heli2src/GRBL_MPG_DRO_with_Teensy_and_mpgWheels/docs/mpg_wheel/readme.txt

 Adafruit Silicone Elastomer 4x4 Button Keypad - for 3mm LEDs
https://eckstein-shop.de/AdafruitSiliconeElastomer4x4ButtonKeypad-for3mmLEDsEN	6,95
