heli2src/GRBL_MPG_DRO_with_Teensy_and_mpgWheels/docs/images/rs485_board.jpg

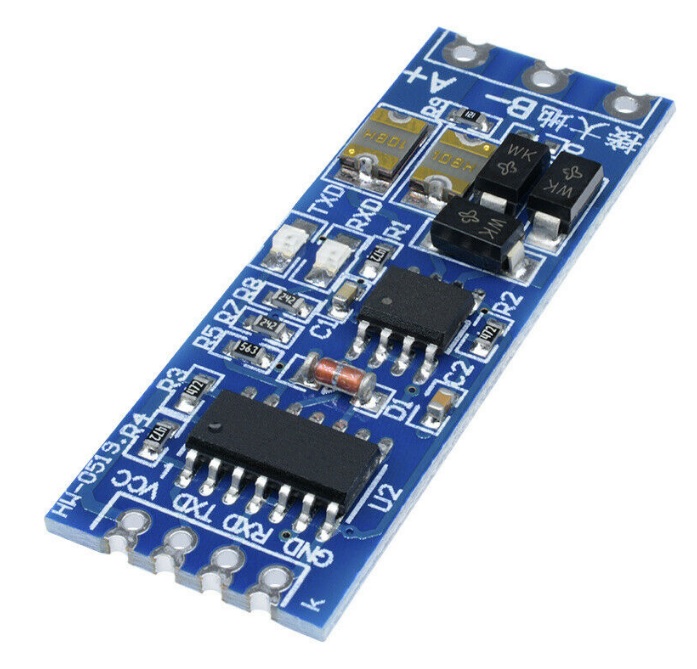
docs/images/rs485_board.jpg
