heli2src/GRBL_MPG_DRO_with_Teensy_and_mpgWheels/docs/images/RS485_board_1.png

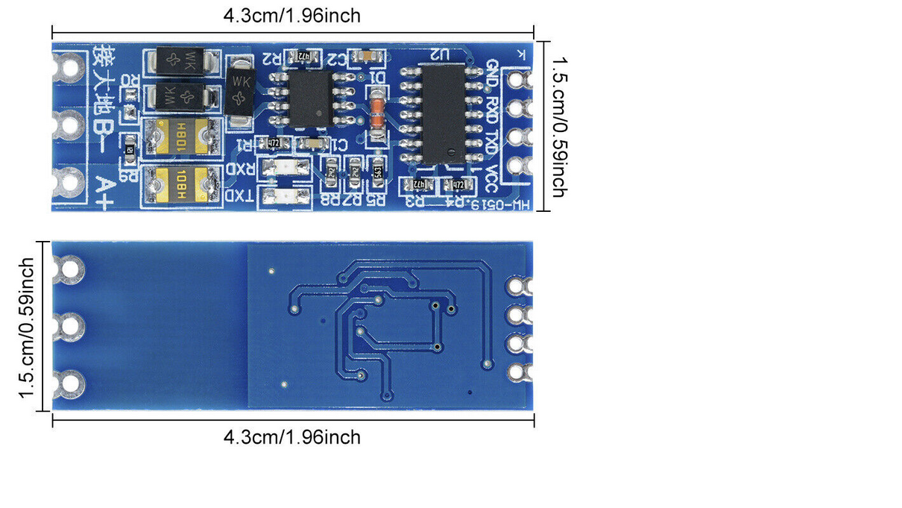
docs/images/RS485_board_1.png
