heli2src/GRBL_MPG_DRO_with_Teensy_and_mpgWheels/docs/images/wheel_1.jpg

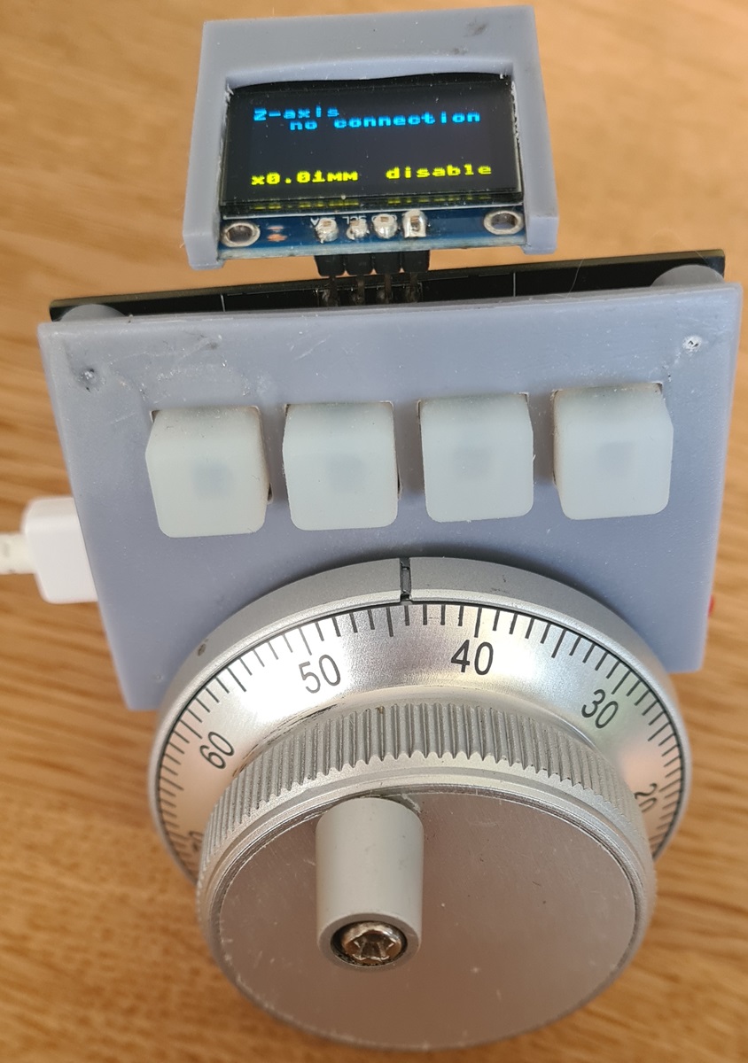
docs/images/wheel_1.jpg
