heli2src/GRBL_MPG_DRO_with_Teensy_and_mpgWheels/docs/mpg_wheel/datasheets/RP2040-Zero.jpg

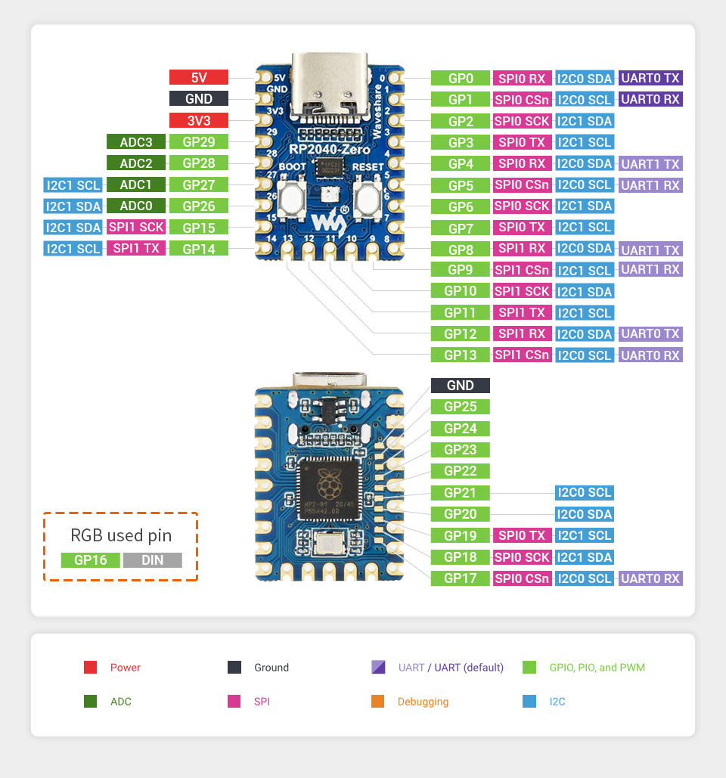
docs/mpg_wheel/datasheets/RP2040-Zero.jpg
