heli2src/GRBL_MPG_DRO_with_Teensy_and_mpgWheels/docs/mpg_wheel/datasheets/Taster.png

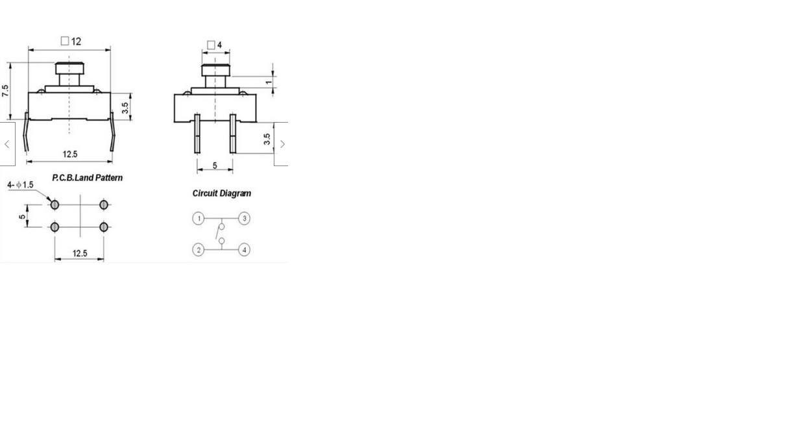
docs/mpg_wheel/datasheets/Taster.png
