heli2src/GRBL_MPG_DRO_with_Teensy_and_mpgWheels/docs/mpg_wheel/datasheets/wheel_outA_3.3V_pullup.jpg

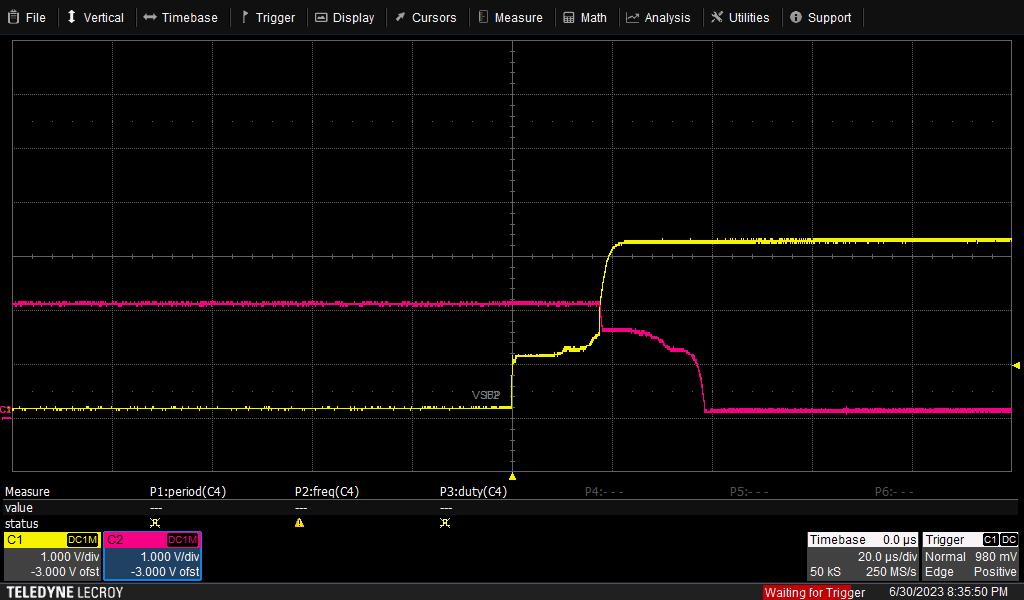
docs/mpg_wheel/datasheets/wheel_outA_3.3V_pullup.jpg
