heli2src/GRBL_MPG_DRO_with_Teensy_and_mpgWheels/cad/LCD_mount20.FCStd

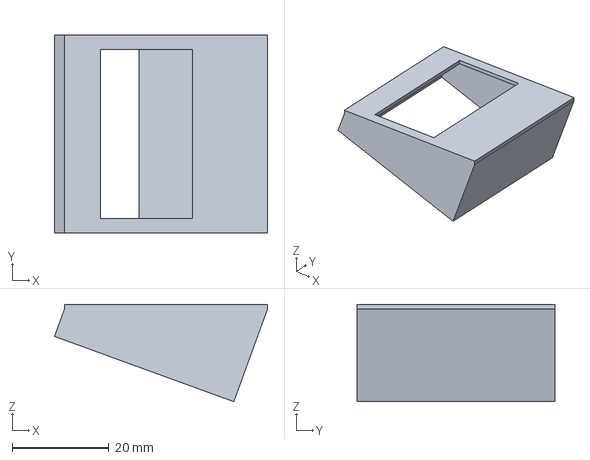
[picture p11: CAD file, 2025-05-06]
cad/LCD_mount20.FCStd
44.1 x 41.0 x 20.1 mm
