heli2src/GRBL_MPG_DRO_with_Teensy_and_mpgWheels/cad/mpg_wheel_mount.dxf

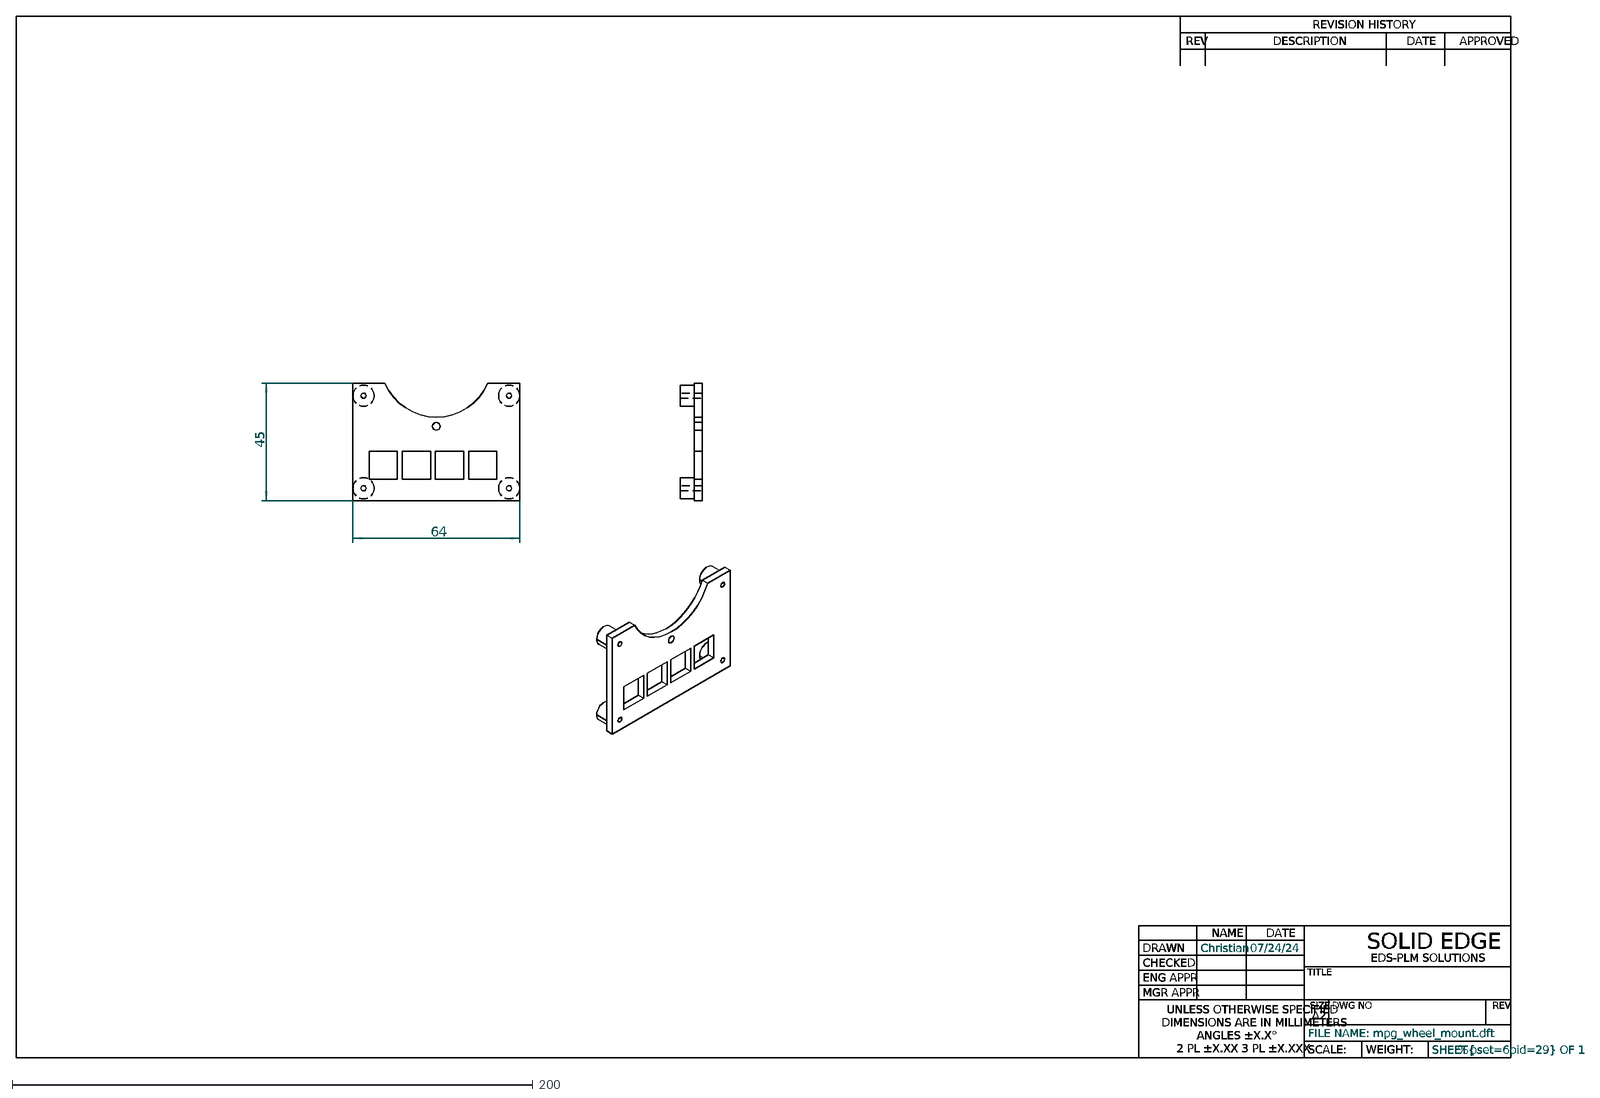
[picture p12: CAD file, 2025-05-06]
cad/mpg_wheel_mount.dxf
45
64
DRAWN
CHECKED
ENG APPR
MGR APPR
UNLESS OTHERWISE SPECIFIED
DIMENSIONS ARE IN MILLIMETERS
ANGLES ±X.X°
2 PL ±X.XX 3 PL ±X.XXX
NAME
Christian
DATE
07/24/24
SOLID EDGE
EDS-PLM SOLUTIONS
TITLE
SIZE
A2
DWG NO
REV
FILE NAME: mpg_wheel_mount.dft
SCALE:
WEIGHT:
SHEET
%{
pset=6pid=29} OF 1
REVISION HISTORY
DESCRIPTION
APPROVED
