heli2src/GRBL_MPG_DRO_with_Teensy_and_mpgWheels/cad/LCD_mount30.FCStd

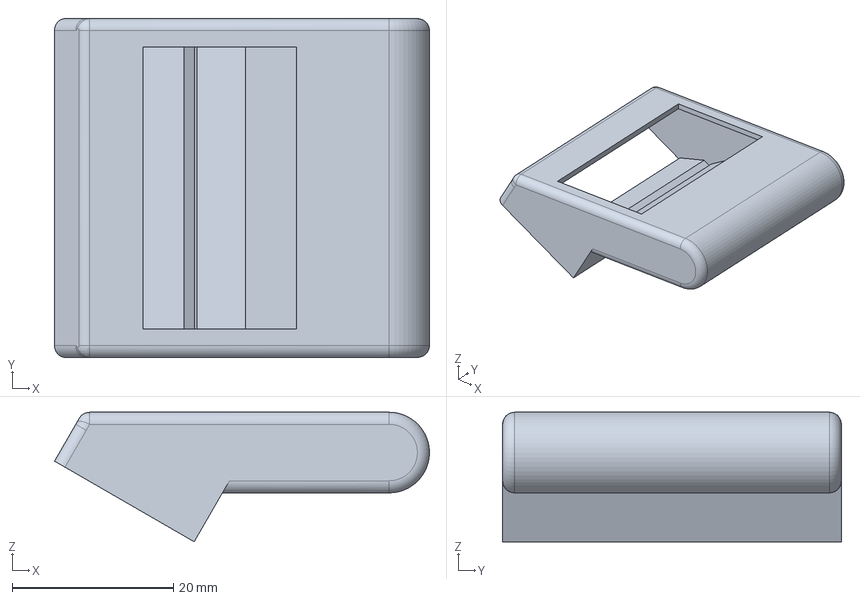
[picture p13: CAD file, 2025-05-06]
cad/LCD_mount30.FCStd
46.5 x 42.0 x 16.1 mm
