heli2src/GRBL_MPG_DRO_with_Teensy_and_mpgWheels/(list of files, cad)

Other CAD files:
cad/LCD_mount20.obj
cad/LCD_mount30.obj
