heli2src/GRBL_MPG_DRO_with_Teensy_and_mpgWheels/boards/RP2040_MPG/RP2040_MPG.kicad_pcb

## KiCad design boards/RP2040_MPG/RP2040_MPG.kicad_pcb (2023-10-13)

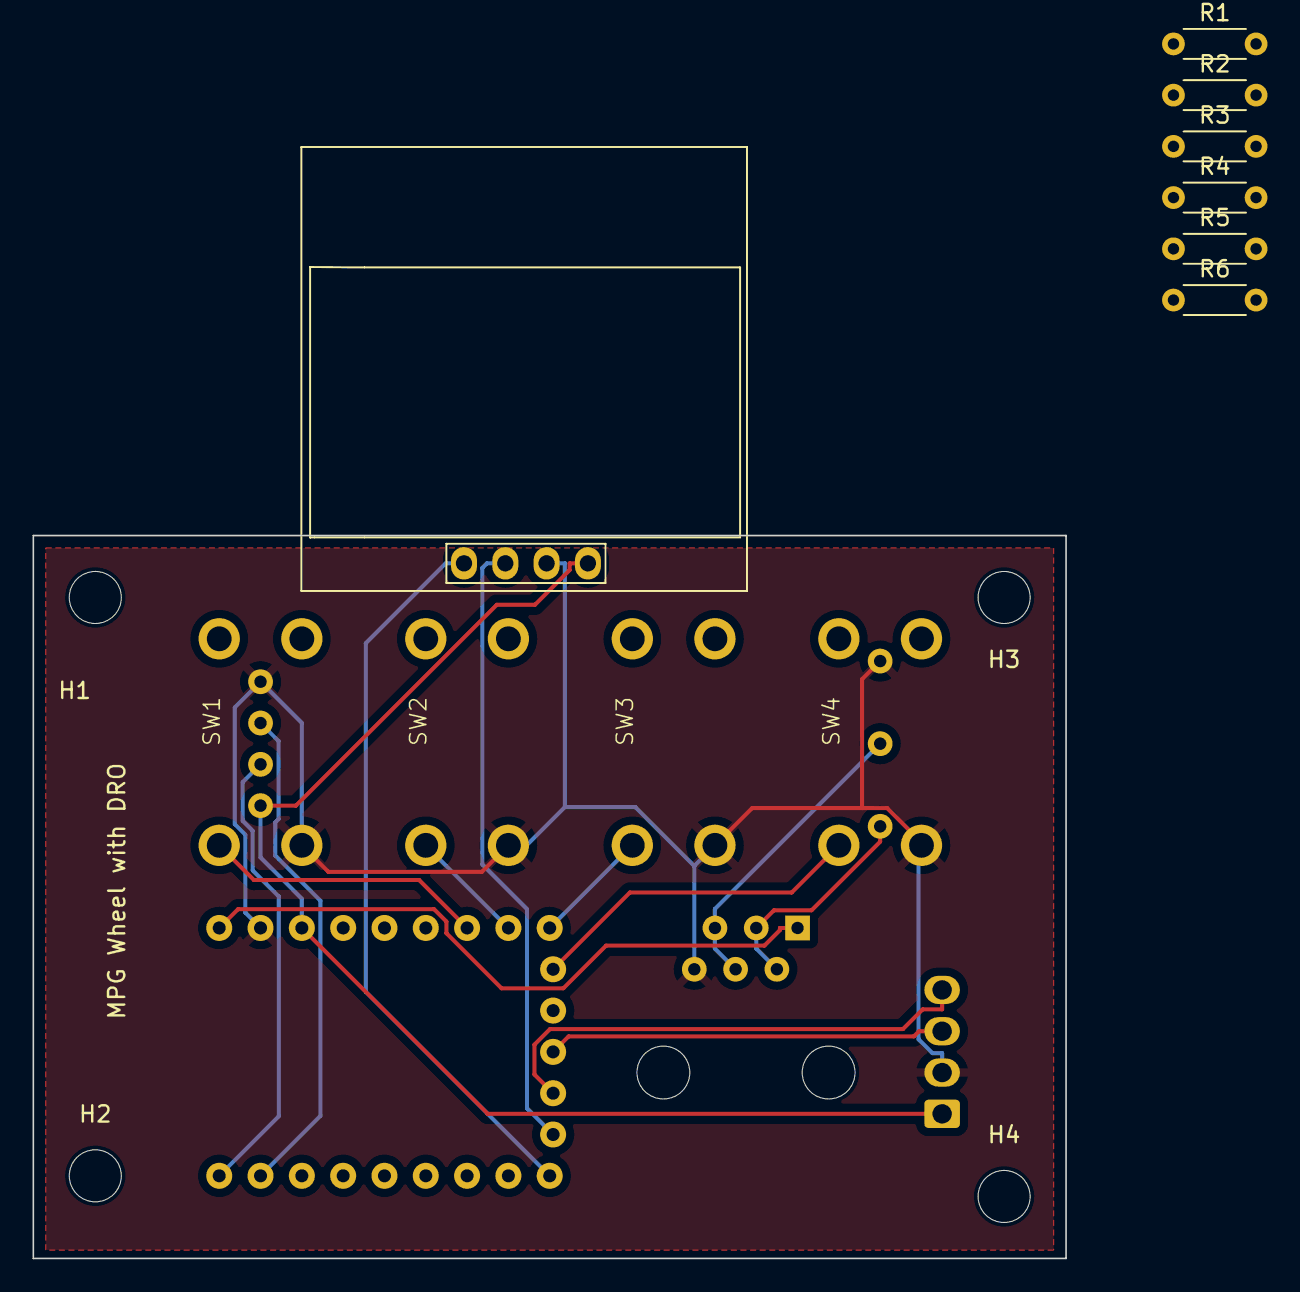
[picture p14: board RP2040_MPG.kicad_pcb from above]

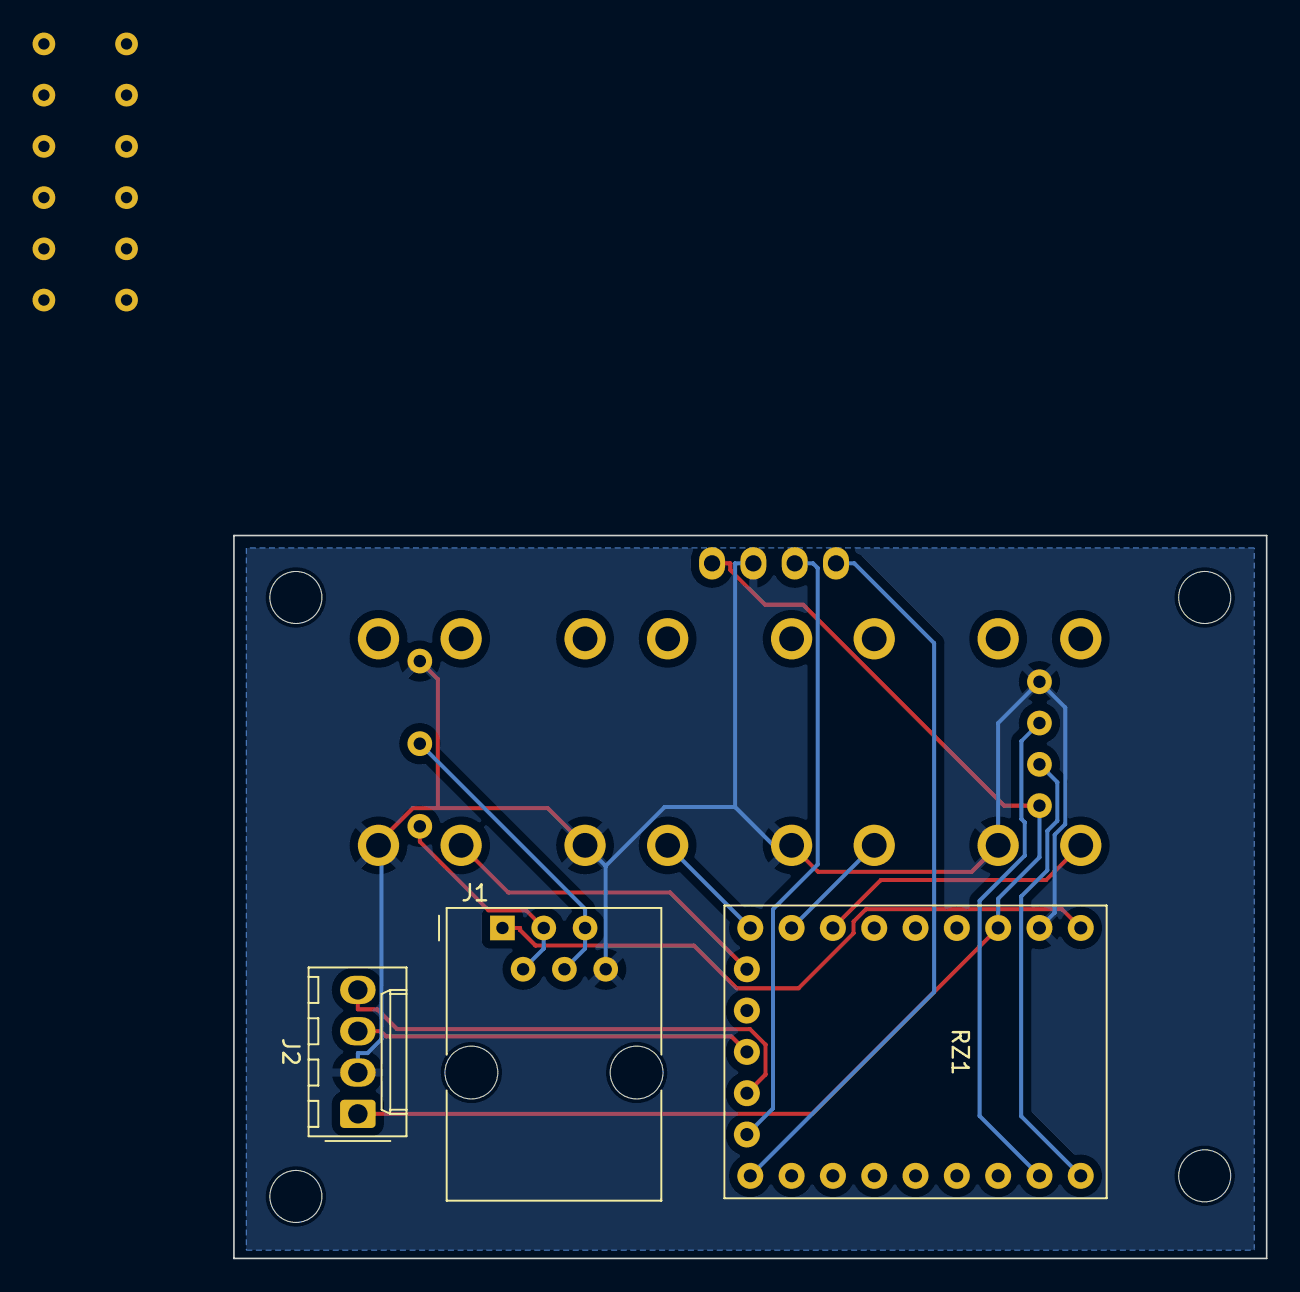
[picture p15: board RP2040_MPG.kicad_pcb from below]

Board: 2 copper layers, 63.5 x 44.5 mm, 19 parts (4 on the bottom side), 21 nets.

Parts:
Brd1: SSD1306; 128x64OLED
H1, H2, H3, H4: MountingHole; MountingHole_3.2mm_M3_DIN965
J1: RJ12; RJ12_Amphenol_54601
J2: Conn_01x04_Socket; Molex_KK-254_AE-6410-04A_1x04_P2.54mm_Vertical
R1, R2, R3, R4, R5, R6: 4k7; R_Axial_DIN0204_L3.6mm_D1.6mm_P5.08mm_Horizontal
RZ1: RP2040-Zero
SW1, SW2, SW3, SW4: SW_Push; Drucktaster_12x12
U2: RS485_2_TTL_UART

Connections:
GND: Brd1.2 (GND), J1.6, J2.2, RZ1.23 (GND), SW1.2, SW2.2, SW3.2, SW4.2, U2.4 (GND), U2.7 (Y)
unnamed: Brd1.3 (SCL), RZ1.10 (GP9)
unnamed: Brd1.4 (SDA), RZ1.9 (GP8)
unnamed: Brd1.1 (VCC), RZ1.21 (3V3), U2.1 (VCC)
unnamed: R1.2, SW4.1
unnamed: R2.2, SW3.1
unnamed: R3.2, SW2.1
unnamed: R4.2, SW1.1
unnamed: J1.1, J2.1, RZ1.22 (5V)
unnamed: J2.3, R6.2
unnamed: J2.4, R5.2
unnamed: RZ1.1 (GP0), U2.2 (TXD)
unnamed: RZ1.2 (GP1), U2.3 (RXD)
unnamed: R5.1, RZ1.11 (GP10)
unnamed: R6.1, RZ1.12 (GP11)
unnamed: R1.1, RZ1.14 (GP13)
unnamed: R2.1, RZ1.15 (GP14)
unnamed: R3.1, RZ1.16 (GP15)
unnamed: R4.1, RZ1.17 (GP26)
unnamed: J1.2, J1.3, U2.5 (A+)
unnamed: J1.4, J1.5, U2.6 (B-)
