heli2src/GRBL_MPG_DRO_with_Teensy_and_mpgWheels/src/main_display_teensy/grbl.h

/*
  config.h - compile time configuration, see note below
  Part of Grbl

  Copyright (c) 2019 Terje Io
  Copyright (c) 2012-2016 Sungeun K. Jeon for Gnea Research LLC
  Copyright (c) 2009-2011 Simen Svale Skogsrud

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
  You should have received a copy of the GNU General Public License
  along with Grbl.  If not, see <http://www.gnu.org/licenses/>.
*/

// NOTE: This file contains parts of config.h copied from grbl for use by MPG/DRO processor

// Define realtime command special characters. These characters are 'picked-off' directly from the
// serial read data stream and are not passed to the grbl line execution parser. Select characters
// that do not and must not exist in the streamed g-code program. ASCII control characters may be
// used, if they are available per user setup. Also, extended ASCII codes (>127), which are never in
// g-code programs, maybe selected for interface programs.
// NOTE: If changed, manually update help message in report.c.

#ifndef __grbl_h__
#define __grbl_h__

#ifdef __cplusplus
 extern "C" {
#endif

#define CMD_EXIT 0x03 // ctrl-C
#define CMD_RESET 0x18 // ctrl-X
#define CMD_STOP 0x19 // ctrl-Y
#define CMD_STATUS_REPORT_LEGACY '?'
#define CMD_CYCLE_START_LEGACY '~'
#define CMD_FEED_HOLD_LEGACY '!'

#define CMD_STATUS_REPORT 0x80
#define CMD_CYCLE_START 0x81
#define CMD_FEED_HOLD 0x82
#define CMD_SAFETY_DOOR 0x84
#define CMD_JOG_CANCEL  0x85
#define CMD_STATUS_REPORT_ALL 0x87

// NOTE: All override realtime commands must be in the extended ASCII character set, starting
// at character value 128 (0x80) and up to 255 (0xFF). If the normal set of realtime commands,
// such as status reports, feed hold, reset, and cycle start, are moved to the extended set
// space, protocol.c's protocol_process_realtime() will need to be modified to accomodate the change.
#define CMD_SAFETY_DOOR 0x84
#define CMD_JOG_CANCEL 0x85
#define CMD_OPTIONAL_STOP_TOGGLE 0x88
#define CMD_SINGLE_BLOCK_TOGGLE 0x89
#define CMD_OVERRIDE_FAN0_TOGGLE 0x8A        // Toggle Fan 0 on/off, not implemented by the core.
#define CMD_MPG_MODE_TOGGLE 0x8B             // Toggle MPG mode on/off, not implemented by the core.
#define CMD_FEED_OVR_RESET 0x90         // Restores feed override value to 100%.
#define CMD_OVERRIDE_FEED_COARSE_PLUS 0x91
#define CMD_OVERRIDE_FEED_COARSE_MINUS 0x92
#define CMD_OVERRIDE_FEED_FINE_PLUS 0x93
#define CMD_OVERRIDE_FEED_FINE_MINUS 0x94
#define CMD_OVERRIDE_RAPID_RESET 0x95        // Restores rapid override value to 100%.
#define CMD_OVERRIDE_RAPID_MEDIUM 0x96
#define CMD_OVERRIDE_RAPID_LOW 0x97
#define CMD_OVERRIDE_SPINDLE_RESET 0x99      // Restores spindle override value to 100%.
#define CMD_OVERRIDE_SPINDLE_COARSE_PLUS 0x9A
#define CMD_OVERRIDE_SPINDLE_COARSE_MINUS 0x9B
#define CMD_OVERRIDE_SPINDLE_FINE_PLUS 0x9C
#define CMD_OVERRIDE_SPINDLE_FINE_MINUS 0x9D
#define CMD_OVERRIDE_SPINDLE_STOP 0x9E
#define CMD_OVERRIDE_COOLANT_FLOOD_TOGGLE 0xA0
#define CMD_OVERRIDE_COOLANT_MIST_TOGGLE 0xA1
#define CMD_TOOL_ACK 0xA3
#define CMD_PROBE_CONNECTED_TOGGLE 0xA4

// Configure rapid, feed, and spindle override settings. These values define the max and min
// allowable override values and the coarse and fine increments per command received. Please
// note the allowable values in the descriptions following each define.
#define DEFAULT_FEED_OVERRIDE           100 // 100%. Don't change this value.
#define MAX_FEED_RATE_OVERRIDE          200 // Percent of programmed feed rate (100-255). Usually 120% or 200%
#define MIN_FEED_RATE_OVERRIDE           10 // Percent of programmed feed rate (1-100). Usually 50% or 1%
#define FEED_OVERRIDE_COARSE_INCREMENT   10 // (1-99). Usually 10%.
#define FEED_OVERRIDE_FINE_INCREMENT      1 // (1-99). Usually 1%.

#define DEFAULT_RAPID_OVERRIDE  100 // 100%. Don't change this value.
#define RAPID_OVERRIDE_MEDIUM    50 // Percent of rapid (1-99). Usually 50%.
#define RAPID_OVERRIDE_LOW       25 // Percent of rapid (1-99). Usually 25%.

#define SPINDLE_NPWM_PIECES                 4 // Maximum number of pieces for spindle RPM linearization, do not change unless more are needed.
#define DEFAULT_SPINDLE_RPM_OVERRIDE      100 // 100%. Don't change this value.
#define MAX_SPINDLE_RPM_OVERRIDE          200 // Percent of programmed spindle speed (100-255). Usually 200%.
#define MIN_SPINDLE_RPM_OVERRIDE           10 // Percent of programmed spindle speed (1-100). Usually 10%.
#define SPINDLE_OVERRIDE_COARSE_INCREMENT  10 // (1-99). Usually 10%.
#define SPINDLE_OVERRIDE_FINE_INCREMENT     1 // (1-99). Usually 1%.

#define MAX_STORED_LINE_LENGTH 80

typedef enum {
    Setting_PulseMicroseconds = 0,
    Setting_StepperIdleLockTime = 1,
    Setting_StepInvertMask = 2,
    Setting_DirInvertMask = 3,
    Setting_InvertStepperEnable = 4,
    Setting_LimitPinsInvertMask = 5,
    Setting_InvertProbePin = 6,
    Setting_StatusReportMask = 10,
    Setting_JunctionDeviation = 11,
    Setting_ArcTolerance = 12,
    Setting_ReportInches = 13,
    Setting_ControlInvertMask = 14,
    Setting_CoolantInvertMask = 15,
    Setting_SpindleInvertMask = 16,
    Setting_ControlPullUpDisableMask = 17,
    Setting_LimitPullUpDisableMask = 18,
    Setting_ProbePullUpDisable = 19,
    Setting_SoftLimitsEnable = 20,
    Setting_HardLimitsEnable = 21,
    Setting_HomingEnable = 22,
    Setting_HomingDirMask = 23,
    Setting_HomingFeedRate = 24,
    Setting_HomingSeekRate = 25,
    Setting_HomingDebounceDelay = 26,
    Setting_HomingPulloff = 27,
    Setting_G73Retract = 28,
    Setting_PulseDelayMicroseconds = 29,
    Setting_RpmMax = 30,
    Setting_RpmMin = 31,
    Setting_LaserMode = 32, // TODO: rename - shared with lathe mode
    Setting_PWMFreq = 33,
    Setting_PWMOffValue = 34,
    Setting_PWMMinValue = 35,
    Setting_PWMMaxValue = 36,
    Setting_StepperDeenergizeMask = 37,
    Setting_SpindlePPR = 38,
    Setting_EnableLegacyRTCommands = 39,

    Setting_HomingLocateCycles = 43,
    Setting_HomingCycle_1 = 44,
    Setting_HomingCycle_2 = 45,
    Setting_HomingCycle_3 = 46,
    Setting_HomingCycle_4 = 47,
    Setting_HomingCycle_5 = 48,
    Setting_HomingCycle_6 = 49,
// Optional driver implemented settings for jogging
    Setting_JogStepSpeed = 50,
    Setting_JogSlowSpeed = 51,
    Setting_JogFastSpeed = 52,
    Setting_JogStepDistance = 53,
    Setting_JogSlowDistance = 54,
    Setting_JogFastDistance = 55,
//
    Setting_RestoreOverrides = 60,
    Setting_IgnoreDoorWhenIdle = 61,
    Setting_SleepEnable = 62,
    Setting_DisableLaserDuringHold = 63,
    Setting_ForceInitAlarm = 64,
    Setting_CheckLimitsAtInit = 65,
    Setting_HomingInitLock = 66,
    Settings_Stream = 70,
// Optional settings for closed loop spindle speed control
    Setting_SpindlePGain = 80,
    Setting_SpindleIGain = 81,
    Setting_SpindleDGain = 82,
    Setting_SpindleDeadband = 83,
    Setting_SpindleMaxError = 84,
    Setting_SpindleIMaxError = 85,
    Setting_SpindleDMaxError = 86,

// Optional settings for closed loop spindle synchronized motion
    Setting_PositionPGain = 90,
    Setting_PositionIGain = 91,
    Setting_PositionDGain = 92,
    Setting_PositionDeadband = 93,
    Setting_PositionMaxError = 94,
    Setting_PositionIMaxError = 95,
    Setting_PositionDMaxError = 96,
//

    Setting_AxisSettingsBase = 100, // NOTE: Reserving settings values >= 100 for axis settings. Up to 255.
    Setting_AxisSettingsMax = 255
} setting_type_t;

#endif

#ifdef __cplusplus
}
#endif
