heli2src/GRBL_MPG_DRO_with_Teensy_and_mpgWheels/src/main_display_teensy/grblcomm.c

#include <string.h>
#include <stdio.h>
#include <stdlib.h>
#include <stdint.h>
#include <stdbool.h>
#include <math.h>

#include "grblcomm.h"


#define SERIAL_NO_DATA -1
#define MAX_BLOCK_LENGTH 256

// This array must match the grbl_state_t enum in grblcomm.h!
const char *const grblState[NUMSTATES] = {
    "Unknown",      //0
    "Idle",         //1
    "Run",          //2
    "Jog",          //3
    "Hold",         //4
    "Alarm",        //5
    "Check",
    "Door",
    "Tool",
    "Home",
    "Sleep"
};

// This array must match the grbl_state_t in grblcomm.h!
//const RGBColor_t grblStateColor[NUMSTATES] = {
const uint16_t grblStateColor[NUMSTATES] = {
    C_WHITE,      //"Unknown",
    C_WHITE,      //"Idle",
    C_GREEN,      //"Run",
    C_YELLOW,     //"Jog",
    C_LTORANGE,   //"Hold",
    C_RED,        //"Alarm",
    C_YELLOW,     //"Check",
    C_LTORANGE,   //"Door",
    C_YELLOW,     //"Tool",
    C_LTBLUE,     //"Home",
    C_LTBLUE,     //"Sleep"
};

static grbl_data_t grbl_data = {
    .changed          = (uint32_t)-1,
    .position         = {0.0f, 0.0f, 0.0f},
    .offset           = {0.0f, 0.0f, 0.0f},
    .debug            = false,
    .absDistance      = true,
    .xModeDiameter    = false,
    .feed_override    = 0,
    .rapid_override   = 0,
    .grbl.state       = Unknown,
    .grbl.state_color = White,
    .grbl.state_text  = "",
    .grbl.substate    = 0,
    .mpgMode          = false,
    .alarm            = 0,
    .error            = 0,
    .pins             = "",
    .message          = "",
    .useWPos          = false,
    .awaitWCO         = true,
    .spindle.on       = false,
    .spindle.ccw      = false,
    .coolant.mist     = false,
    .coolant.flood    = false
};

static void parseData (char *block);

settings_t settings = {
    .spindle.rpm     = 0.0f,
    .spindle.mpg_rpm = 200.0f,
    .spindle.rpm_min = 0.0f,
    .spindle.rpm_max = 1000.0f,
    .jog_config.step_speed    = 100.0f,
    .jog_config.slow_speed    = 600.0f,
    .jog_config.fast_speed    = 3000.0f,
    .jog_config.step_distance = 0.1f,
    .jog_config.slow_distance = 500.0f,
    .jog_config.fast_distance = 500.0f
};

static grbl_info_t grbl_info = {
    .options = {0},
    .device  = "grblHAL MPG & DRO",
};

static struct {
    grbl_settings_received_ptr on_settings_received;             
    grbl_info_received_ptr on_info_received;
    grbl_callback_ptr on_report_received;
    grbl_sd_files_received_ptr on_sd_files_received;
    grbl_callback_ptr on_line_received;
} grbl_event = {
    .on_settings_received = NULL,
    .on_info_received = NULL,
    .on_report_received = NULL,
    .on_sd_files_received = NULL,
    .on_line_received = parseData
};

static sd_files_t sd_files = {0};

static bool legacy_rt_commands = true;
static volatile bool ack_received = false, await = false;
static void (*grblTransmitCallback)(bool ok, grbl_data_t *grbl_data) = 0;
grbl_settings_received_ptr on_settings_received = NULL;

void setGrblLegacyMode (bool on)
{
    legacy_rt_commands = on;
}

char mapRTC2Legacy (char c)
{
    if(legacy_rt_commands) switch(c) {

        case CMD_STATUS_REPORT:
            c = CMD_STATUS_REPORT_LEGACY;
            break;

        case CMD_CYCLE_START:
            c = CMD_CYCLE_START_LEGACY;
            break;

        case CMD_FEED_HOLD:
            c = CMD_FEED_HOLD_LEGACY;
            break;
    }

    return c;
}

grbl_data_t *setGrblReceiveCallback (grbl_callback_ptr fn)
{
    grbl_event.on_report_received = fn;
    grblTransmitCallback = NULL;
    grbl_data.changed.flags = (uint32_t)-1;
    grbl_data.changed.await_ack = grbl_data.changed.reset = false;
    grbl_data.changed.unassigned = 0;

    return &grbl_data;
}

bool grblIsMPGActive (void)
{
    return grbl_data.mpgMode;
}

static void processReply (char *line)
{
    grblTransmitCallback(strcmp(line, "ok") == 0, &grbl_data);
}

void setGrblTransmitCallback (void (*fn)(bool ok, grbl_data_t *grbl_data))
{
    grblTransmitCallback = fn;
    grbl_event.on_report_received = fn ? processReply : NULL;
}

void grblSerialFlush (void)
{
    serial_RxCancel();
}

static bool parseDecimal (float *value, char *data)
{
    bool changed;

    float val = (float)atof(data);
    if((changed = val != *value))
        *value = val;

    return changed;
}

static bool parseInt (int32_t *value, char *data)
{
    bool changed;

    int32_t val = (int32_t)atoi(data);
    if((changed = val != *value))
        *value = val;

    return changed;
}

static void parsePositions (char *data)
{
    char *next;

    next = strchr(data, ',');
    *next++ = '\0';

    if(parseDecimal(&grbl_data.position[X_AXIS], data))
        grbl_data.changed.xpos = true;

    data = next;
    next = strchr(data, ',');
    *next++ = '\0';

    if(parseDecimal(&grbl_data.position[Y_AXIS], data))
        grbl_data.changed.ypos = true;

    if(parseDecimal(&grbl_data.position[Z_AXIS], next))
        grbl_data.changed.zpos = true;
}

static void parseOffsets (char *data)
{
    if(grbl_data.useWPos) {

        grbl_data.changed.offset = grbl_data.offset[X_AXIS] != 0.0f ||
                                    grbl_data.offset[Y_AXIS] != 0.0f ||
                                     grbl_data.offset[Z_AXIS] != 0.0f;

        grbl_data.offset[X_AXIS] =
        grbl_data.offset[Y_AXIS] =
        grbl_data.offset[Z_AXIS] = 0.0f;

    } else {

        char *next;

        next = strchr(data, ',');
        *next++ = '\0';

        if(parseDecimal(&grbl_data.offset[X_AXIS], data))
            grbl_data.changed.offset = true;

        data = next;
        next = strchr(data, ',');
        *next++ = '\0';

        if(parseDecimal(&grbl_data.offset[Y_AXIS], data))
            grbl_data.changed.offset = true;

        if(parseDecimal(&grbl_data.offset[Z_AXIS], next))
            grbl_data.changed.offset = true;
    }

    grbl_data.changed.await_wco_ok = grbl_data.awaitWCO;
}


static void parseOverrides (char *data)
{
    char *next;

    next = strchr(data, ',');
    *next++ = '\0';

    if(parseInt(&grbl_data.feed_override, data))
        grbl_data.changed.feed_override = true;

    data = next;
    next = strchr(data, ',');
    *next++ = '\0';

    if(parseInt(&grbl_data.rapid_override, data))
        grbl_data.changed.rapid_override = true;

    if(parseInt(&grbl_data.spindle.rpm_override, next))
        grbl_data.changed.rpm_override = true;
}

static void parseFeedSpeed (char *data)
{
    char *next;

    next = strchr(data, ',');
    *next++ = '\0';

    if(parseDecimal(&grbl_data.feed_rate, data))
        grbl_data.changed.feed = true;

    data = next;
    if((next = strchr(data, ',')))
        *next++ = '\0';

    if(parseDecimal(&grbl_data.spindle.rpm_programmed, data))
        grbl_data.changed.rpm = true;

    if(next && parseDecimal(&grbl_data.spindle.rpm_actual, next))
        grbl_data.changed.rpm = true;
}

static void parseData (char *block)
{
    static char buf[MAX_BLOCK_LENGTH];

    uint32_t c;
    bool pins = true;
    char *line = &buf[0];

    //serial0_writeLn("   parseData:");
    //serial0_writeLn(buf);   

    if((ack_received = !strcmp(block, "ok"))) {
        grbl_data.changed.await_ack = false;
        // serial0_writeLn("   parseData: clear Error/Alarms");
        grblClearError(); // TODO: grbl needs to be fixed for continuing to process from input buffer after error...
        if(grbl_data.alarm)
            grblClearAlarm();
        return;
    }
    if (block[0] == '<' && block[strlen(block)-1] != '>') {
            //serial0_write(block);
            //serial0_write(block[0]);
            //serial0_write(block[strlen(block)-1]);
            //serial0_writeLn("|    ->wrong block -> discard");
        return;
    }

    if(block[0] == '<' || block[0] =='[') // strip last character from long messages
        block[strlen(block) - 1] = '\0';
    if(block[0] == '<')
        for (int i = 1;i<strlen(block);i++)
            if (block[i] == '<') {
                serial0_writeLn(grbl_data.block);
                serial0_writeLn(" read error --> discard");               
                return;
            }               
    //serial0_writeLn(grbl_data.block);      // CJ for debugging

    strncpy(line, block, MAX_BLOCK_LENGTH);
    line[MAX_BLOCK_LENGTH - 1] = '\0';


    if(line[0] == '<') {
      
        pins = false;
        line = strtok(&line[1], "|");

        if(line) {

            if(grblParseState(line, &grbl_data.grbl)) {

                grbl_data.changed.state = true;

                if(!(grbl_data.grbl.state == Alarm || grbl_data.grbl.state == Tool) && grbl_data.message[0] != '\0')
                    grblClearMessage();
            }

            if(grbl_data.alarm && grbl_data.grbl.state != Alarm)
                grblClearAlarm();

            line = strtok(NULL, "|");
        }

        while(line) {

            if(!strncmp(line, "WPos:", 5)) {
                if(!grbl_data.useWPos) {
                    grbl_data.useWPos = true;
                    grbl_data.changed.offset = true;
                }
                parsePositions(line + 5);

            } else if(!strncmp(line, "MPos:", 5)) {
                if(grbl_data.useWPos) {
                    grbl_data.useWPos = false;
                    grbl_data.changed.offset = true;
                }
                parsePositions(line + 5);

            } else if(!strncmp(line, "FS:", 3))
                parseFeedSpeed(line + 3);

            else if(!strncmp(line, "WCO:", 4))
                parseOffsets(line + 4);

            else if(!strncmp(line, "Pn:", 3)) {
                pins = true;
                if((grbl_data.changed.pins = (strcmp(grbl_data.pins, line + 3) != 0)));
                    strcpy(grbl_data.pins, line + 3);

            } else if(!strncmp(line, "D:", 2)) {
                grbl_data.xModeDiameter = line[2] == '1';
                grbl_data.changed.xmode = true;

            } else if(!strncmp(line, "A:", 2)) {

                line = &line[2];
                grbl_data.spindle.on =
                grbl_data.spindle.ccw =
                grbl_data.coolant.flood =
                grbl_data.coolant.mist = false;
                grbl_data.changed.leds = true;

                while((c = *line++)) {
                    switch(c) {

                        case 'M':
                            grbl_data.coolant.mist = true;
                            break;

                        case 'F':
                            grbl_data.coolant.flood = true;
                            break;

                        case 'S':
                            grbl_data.spindle.ccw = false;
                            grbl_data.spindle.on = true;
                            break;

                        case 'C':
                           grbl_data.spindle.ccw = true;
                           grbl_data.spindle.on = true;
                           break;
                    }
                }

            } else if(!strncmp(line, "Ov:", 3))
                parseOverrides(line + 3);

            else if(!strncmp(line, "MPG:", 4)) {
                if(grbl_data.mpgMode != (line[4] == '1')) {
                    grbl_data.mpgMode = !grbl_data.mpgMode;
                    grbl_data.changed.mpg = true;
                    grbl_event.on_line_received = parseData;
                }
            } else if(!strncmp(line, "SD:", 3)) {
                if((grbl_data.changed.message = !!strcmp(grbl_data.message, line + 3)))
                    strncpy(grbl_data.message, line + 3, 250);
            }

            line = strtok(NULL, "|");
        }

        if(!pins && (grbl_data.changed.pins = (grbl_data.pins[0] != '\0')))
            grbl_data.pins[0] = '\0';

    } else if(line[0] == '[') {
        line++;
        
        if(!strncmp(line, "GC:", 3)) {

            line = strtok(&line[3], " ");
            
            while(line) {

                if(!strncmp(line, "F", 1) && parseDecimal(&grbl_data.feed_rate, line + 1))
                    grbl_data.changed.feed = true;

                if(!strncmp(line, "S", 1) && parseDecimal(&grbl_data.spindle.rpm_programmed, line + 1))
                    grbl_data.changed.rpm = true;

                if(!strncmp(line, "G7", 2)) {
                    grbl_data.xModeDiameter = true;
                    grbl_data.changed.xmode = true;
                }

                if(!strncmp(line, "G8", 2)) {
                    grbl_data.xModeDiameter = false;
                    grbl_data.changed.xmode = true;
                }

                if(!strncmp(line, "G90", 3) && !grbl_data.absDistance) {
                    grbl_data.absDistance = true;
                    grbl_data.changed.dist = true;
                }

                if(!strncmp(line, "G91", 3) && grbl_data.absDistance) {
                    grbl_data.absDistance = false;
                    grbl_data.changed.dist = true;
                }

                if(!strncmp(line, "M5", 2)) {
                    if(grbl_data.spindle.on)
                        grbl_data.changed.leds = true;
                    grbl_data.spindle.on = false;
                } else if(!strncmp(line, "M3", 2)) {
                    if(!grbl_data.spindle.on || grbl_data.spindle.ccw)
                        grbl_data.changed.leds = true;
                    grbl_data.spindle.on = true;
                    grbl_data.spindle.ccw = false;
                } else if(!strncmp(line, "M4", 2)) {
                    if(!grbl_data.spindle.on || !grbl_data.spindle.ccw)
                        grbl_data.changed.leds = true;
                    grbl_data.spindle.on = true;
                    grbl_data.spindle.ccw = true;
                }

                if(!strncmp(line, "M9", 2)) {
                    if(grbl_data.coolant.mist || grbl_data.coolant.flood)
                        grbl_data.changed.leds = true;
                    grbl_data.coolant.mist = false;
                    grbl_data.coolant.flood = false;
                } else {
                    if(!strncmp(line, "M7", 2)) {
                        if(!grbl_data.coolant.mist)
                            grbl_data.changed.leds = true;
                        grbl_data.coolant.mist = true;
                    }
                    if(!strncmp(line, "M8", 2)) {
                        if(!grbl_data.coolant.mist)
                            grbl_data.changed.leds = true;
                        grbl_data.coolant.flood = true;
                    }
                }
                line = strtok(NULL, " ");
            }
        } else if(!strncmp(line, "MSG:", 4)) {
            grbl_data.changed.message = true;
            strncpy(grbl_data.message, line + 4, 250);
        }
    } else if(!strncmp(line, "error:", 6)) {
        grbl_data.error = (uint8_t)atoi(line + 6);
        grbl_data.changed.error = true;
    } else if(!strncmp(line, "ALARM:", 6)) {
        grbl_data.alarm = (uint8_t)atoi(line + 6);
        grbl_data.changed.alarm = true;
    } else if(!strncmp(line, "Grbl", 4)) {
        grbl_data.changed.reset = true;
        grblClearError();
        grblClearAlarm();
        grblClearMessage();
        grbl_event.on_line_received = parseData;
    }

    if(grbl_event.on_report_received && !grbl_data.changed.await_ack)
        grbl_event.on_report_received(grbl_data.block);    
}

void grblClearAlarm (void)
{
    grbl_data.changed.alarm = grbl_data.alarm != 0;
    grbl_data.alarm = 0;
}

void grblClearError (void)
{
    grbl_data.changed.error = grbl_data.error != 0;
    grbl_data.error = 0;
}

void grblClearMessage (void)
{
    grbl_data.changed.message = grbl_data.message[0] != '\0';
    grbl_data.message[0] = '\0';
}

void grblSendSerial (char *line)
{
    serial_writeLn(line);
}

bool grblParseState (char *data, grbl_t *grbl)
{
    bool changed = false;
    uint_fast8_t len, substate = 0;
    char *s = strchr(data, ':');

    if(s) {
        *s++ = '\0';
        substate = atoi(s);
    }

    len = strlen(data);

    if(len < sizeof(grbl->state_text) && strncmp(grbl->state_text, data, len)) {
        uint_fast8_t state = 0;
        while(state < NUMSTATES) {
            if((changed = !strcmp(data, grblState[state]))) {
                grbl->state = (grbl_state_t)state;
                grbl->substate = substate;
                grbl->state_color = grblStateColor[state];
                strcpy(grbl->state_text, data);
                break;
            }
            state++;
        }
    }

    if(!changed && grbl->substate != substate) {
        changed = true;
        grbl->substate = substate;
    }

    return changed;
}

static void parse_info (char *line)
{
    //serial0_writeLn("parse_info");
    if(!strcmp(line, "ok")) {
        grbl_event.on_line_received = parseData;
        if(grbl_event.on_info_received) {
            grbl_event.on_info_received(&grbl_info);
            grbl_event.on_info_received = NULL;
        }
    } else if(!strncmp(line, "[VER:", 5)) {
        grbl_info.is_loaded = true;
        if((line = strchr(line + 5, ':')))
            line[strlen(line) - 1] = '\0';
        if(line && (++line)[0] != '\0') {
            strncpy(grbl_info.device, line, MAX_STORED_LINE_LENGTH - 1);
            grbl_info.device[MAX_STORED_LINE_LENGTH - 1] = '\0';
        }
    } else if(!strncmp(line, "[NEWOPT:", 8)) {
        serial0_writeLn("NEWOPT");
        line[strlen(line) - 1] = '\0';
        line = strtok(&line[8], ",");
        grbl_info.options.lathe=0;
        while(line) {

            if(!strncmp(line, "SD", 2))
                grbl_info.options.sd_card = true;
            else if(!strncmp(line, "TC", 2))
                grbl_info.options.tool_change = true;
            else if(!strncmp(line, "LATHE", 5))
                grbl_info.options.lathe=1;
            line = strtok(NULL, ",");
        }
        grbl_data.changed.state = true;
    } else{
        //serial0_writeLn("parseData");
        parseData(line);
    }
}

void grblGetInfo (grbl_info_received_ptr on_info_received)
{
    if(grbl_event.on_line_received == parseData) {
//CJ    if(grbl_data.mpgMode && grbl_event.on_line_received == parseData) {
        serial0_writeLn("grblGetInfo()");
        grbl_event.on_info_received = on_info_received;
        grbl_event.on_line_received = parse_info;
        serial_RxCancel();
        serial_writeLn("$I");
    } else if (on_info_received)
        serial0_writeLn("grblGetInfo: display last infos");
        on_info_received(&grbl_info); // return default values
}

grbl_options_t grblGetOptions (void)
{
    return grbl_info.options;
}

static void parse_settings (char *line)
{
    static uint_fast16_t setting = 0;

    if(!strcmp(line, "ok")) {
        grbl_event.on_line_received = parseData;
        settings.is_loaded = setting > 0;
        if(grbl_event.on_settings_received) {
            grbl_event.on_settings_received(&settings);
            grbl_event.on_settings_received = NULL;
        }
    } else if(line[0] == '$' && strchr(line, '=')) {

        line = strtok(&line[1], "=");
        setting = atoi(line);
        line = strtok(NULL, "=");
        float value = atof(line);

        switch((setting_type_t)setting) {

            case Setting_JogStepSpeed:
                settings.jog_config.step_speed = value;
                break;

            case Setting_JogSlowSpeed:
                settings.jog_config.slow_speed = value;
                break;

            case Setting_JogFastSpeed:
                settings.jog_config.fast_speed = value;
                break;

            case Setting_JogStepDistance:
                settings.jog_config.step_distance = value;
                break;

            case Setting_JogSlowDistance:
                settings.jog_config.slow_distance = value;
                break;

            case Setting_JogFastDistance:
                settings.jog_config.fast_distance = value;
                break;

            case Setting_RpmMin:
                settings.spindle.rpm_min = value;
                break;

            case Setting_RpmMax:
                settings.spindle.rpm_max = value;
                break;

            case Setting_EnableLegacyRTCommands:
                setGrblLegacyMode((uint32_t)value != 0);
                break;

            case Setting_HomingEnable:
                settings.homing_enabled = ((uint32_t)value & 0x01) != 0;
                break;

            case Setting_LaserMode:
                settings.mode = (uint32_t)value;
                break;

            default:
                break;
        }
    } else
        parseData(line);
}

void grblGetSettings (grbl_settings_received_ptr on_settings_received)
{
    if(grbl_data.mpgMode && grbl_event.on_line_received == parseData) {
        grbl_event.on_settings_received = on_settings_received;
        grbl_event.on_line_received = parse_settings;
        serial_RxCancel();
        serial_writeLn("$$");
    } else if (on_settings_received)
        on_settings_received(&settings); // return default values
}

static void parse_sd_files (char *line)
{
    if(!strcmp(line, "ok")) {
        grbl_event.on_line_received = parseData;
        if(grbl_event.on_sd_files_received) {
            grbl_event.on_sd_files_received(&sd_files);
            grbl_event.on_sd_files_received = NULL;
        }
    } else if(!strncmp(line, "[FILE:", 6)) {

        sd_file_t *file, *next = sd_files.files;
        
        if((file = (sd_file_t *)malloc(sizeof(sd_file_t)))) {
        
            char *size;
            
            line += 6;
            if((size = strstr(line, "|SIZE:"))) {
                *size = '\0';
                size += 6;
            }

            strcpy(file->name, line);
            file->next = NULL;

            if(size && ((line = strchr(size, '|')) || (line = strchr(size, ']')))) {
                *line = '\0';
                file->length = (uint32_t)atoi(size);
            } else
                file->length = 0;

            if(sd_files.files == NULL)
                sd_files.files = file;
            else {
                while(next->next)
                    next = next->next;
                next->next= file;    
            }
            sd_files.num_files++;
        }    
    } else
        parseData(line);
}

void grblGetSDFiles (grbl_sd_files_received_ptr on_sd_files_received)
{
    if(grbl_data.mpgMode && grbl_info.options.sd_card && grbl_event.on_line_received == parseData) {
        sd_file_t *file ;
        while(sd_files.files) {
            file = sd_files.files->next;
            free(sd_files.files);
            sd_files.files = file;
        }
        sd_files.num_files = 0;
        grbl_event.on_sd_files_received = on_sd_files_received;
        grbl_event.on_line_received = parse_sd_files;
        serial_RxCancel();
        serial_writeLn("$F");
    } else if (on_settings_received)
        on_sd_files_received(&sd_files); // return default values
}

static void await_ack (char *line)
{
    ack_received = !strcmp(line, "ok");
}

bool grblAwaitACK (const char *command, uint_fast16_t timeout_ms)
{
    ack_received = false;
    grbl_data.changed.await_ack = true;
//    grbl_event.on_line_received = await_ack;
    serial_RxCancel();
    serial_writeLn(command);

    timeout_ms += lcd_systicks();         // lcd_systicks() comes from lib interface
    while(!ack_received && lcd_systicks() <= timeout_ms)
        grblPollSerial();

    grbl_data.changed.await_ack = false;
//    grbl_event.on_line_received = parseData;

    return ack_received;
}

void grblDebug(short debug)
{   grbl_data.debug = debug;
} 

void grblPollSerial (void)
{
    static int_fast16_t c;
    static uint_fast16_t char_counter = 0;
    bool dec_debug = false;

    while((c = serial_getC()) != SERIAL_NO_DATA) {

        if(c == 0x18) //ASCII_CAN
            char_counter = 0;
        else if(((c == '\n') || (c == '\r'))) { // End of line reached
          
            grbl_data.block[char_counter] = '\0';

            if (grbl_data.debug !=0 ) {
                serial0_writeLn(grbl_data.block);
                if (grbl_data.debug)
                    dec_debug = true;
            }

            if(char_counter > 0)
                 grbl_event.on_line_received(grbl_data.block);

            char_counter = 0;

        } else if(char_counter < MAX_BLOCK_LENGTH - 1)
            grbl_data.block[char_counter++] = (char)c;
    }
    if (dec_debug)
        grbl_data.debug--;
}
