heli2src/GRBL_MPG_DRO_with_Teensy_and_mpgWheels/src/main_display_teensy/switch.h

#include "dro.h"

typedef struct {
    bool Button1=false;
    bool Button2=false;
  }struButtons;

struButtons Sbutton;


/* ------------------
   Public FUNCTIONS
   ------------------ */
void Switch_init(void);
void Switch_loop(void);
void Switch_mode(int mode);
