heli2src/GRBL_MPG_DRO_with_Teensy_and_mpgWheels/(commit log)

2023-02-25 add mpg wheel
2023-04-12 add title
    [RP2040_MPG.kicad_sch]
2023-06-27 add spec for wheel
2023-06-27 store error and alarm codes in extra file
    [error_alarmcodes.h]
2023-07-02 fix wrong cnt values, if handwheel get an reset
    [handwheel.ino]
2023-07-02 fix error with alarm/error state with new code structure
    [mydisplay.ino]
2023-07-02 add osci pictures from mpg wheel with different voltages
2023-07-04 add class for the rgb led from pico zero
2023-07-17 fix error in axis, comment debug prints
    [handwheel.ino, mydisplay.ino]
2023-07-26 add RC vor switches and MPG
    [RP2040_MPG.kicad_sch]
2023-07-26 create bracket for lcd-display
    [LCD_mount20.stl]
2023-08-08 add 2 switch buttons
2023-08-10 increase cycletime for mpg wheel
2023-08-10 use arduino 1.8.19 for compiling
2023-08-13 add mirrored switch layout
2023-08-13 add key functions from mpg-wheel
2023-08-26 add drive axis =0 and replace target value with actual value
    [dro.c, mydisplay.h, mydisplay.ino]
2023-09-03 fix unformated error display
    [error_alarmcodes.h]
2023-09-03 change rc filter
    [RP2040_MPG.kicad_pcb, RP2040_MPG.kicad_sch]
2024-07-21 add switch beetwenn lathe/milling
2024-07-22 add manual calibration touch screen
2024-07-23 add 4xswitches
    [RP2040_MPG.kicad_sch]
2024-07-23 add emv circuits
    [Teensy3.2_DRO.kicad_sch]
2024-07-23 improve readme and add pictures/cad drawings
    [LCD-mount40.igs, LCD-mount60.igs, LCD_mount20.stl, LCD_mount40.stl, LCD_mount60.stl, mpg_wheel_mount.igs, mpg_wheel_mount.stl]
2024-07-23 add changing axis with buttons
2024-10-12 add switching between CNC-Mode and manual mode
2025-05-06 replace SSD1306oled with SH1106
    [LCD-mount40.igs, LCD-mount60.igs, LCD_mount20.FCStd, LCD_mount20.obj, LCD_mount30.FCStd, LCD_mount30.obj, LCD_mount40.stl, LCD_mount60.stl]
2025-05-17 update code for arduino 2.3 compilation
2025-05-28 fix button mpg-Button not functional...
    [dro.h, grblcomm.h, mydisplay.ino, switch.ino]
2025-05-28 add display feed rate in milling mode
2025-05-28 add macro for pocket milling
