heli2src/GRBL_MPG_DRO_with_Teensy_and_mpgWheels/(notices)

Notices in the files:
src/main_display_teensy/grbl.h:
Grbl is free software: you can redistribute it and/or modify
it under the terms of the GNU General Public License as published by
the Free Software Foundation, either version 3 of the License, or
(at your option) any later version.
